cattoorseba/2ndlinefollower/code/proof of concepts/hbridge/Informatieve filmpjes Hbrug.docx

Informatieve filmpjes:

- Motor driver met 2 ingewerkte hbruggen: (L293)

https://www.youtube.com/watch?v=GAyzaVSBvN0

https://www.youtube.com/watch?v=D4yLsWvZDw4

https://www.youtube.com/shorts/5CbHtl4Vu8g

https://www.youtube.com/watch?v=GPVC84D5ULw
