cattoorseba/2ndlinefollower/code/finaal/library qtr.pdf

### LIBRARY

Om dit programma effecef te laten werken heb je een library nodig. Deze heet:

QTRSensors by Pololu
!!! VERSIE 3.1.0 !!!

hps://github.com/pololu/qtr-sensors-arduino
