cattoorseba/2ndlinefollower/images/456382504_514978801026128_8312329573464532869_n.jpg

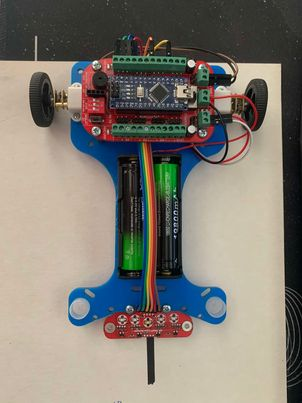
images/456382504_514978801026128_8312329573464532869_n.jpg
