cattoorseba/2ndlinefollower/images/457664521_521857643715942_9092791686252640069_n.jpg

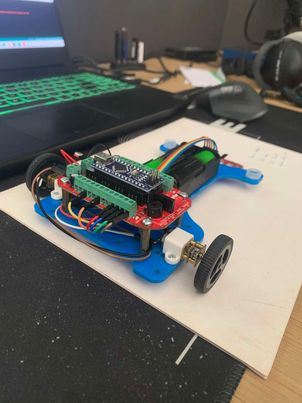
images/457664521_521857643715942_9092791686252640069_n.jpg
