cattoorseba/2ndlinefollower/bill of materials/readme.md

## bill of materials
<br />

|volgnummer|naam|omschrijving|nieuw/recup|kostprijs/stuk|aantal|subtotaal|
|---|----|---|---|---|---|---|
| 1| Basisplaat| Plastic uitgesneden basisplaat| nieuw| 20€| 1| 20€|
| 2| DC gear motor| 50:1 6V 650rpm| recup| 0€| 2| 0€|
| 3| Motorhouders| Plastic onderdeeltjes om de motor op zijn plek te houden| recup| 0€| 2| 0€|
| 4| Wieltjes| 30mm| recup| 0€| 2| 0€|
| 5| Arduino draadjes| (Male-Male)| recup| 0€| 4| 0€|
| 6| Arduino draadjes| (Male-Female)| recup| 0€| 6| 0€|
| 7| Arduino Robot Board| PCB Arduino-gebaseerde robotkaart| nieuw| 15€| 1| 15€|
| 8| L293 Motorsturing| motorsturing met 2 h-bruggen| recup| 0€| 1| 0€|
| 9| Arduino Nano| Atmega328| recup| 0€| 1| 0€|
| 10| Monteerstaafjes| bevestiging voor robot board op basisplaat| recup| 0€| 4| 0€|
| 11| Herlaadbare Li-ion batterij| 19800mAh, 3,7V| recup| 0€| 2| 0€|
| 12| Li-ion batterijhouder| batterijhouder 18650x2| recup| 0€| 1| 0€|
| 13| analoge Multi line sensor| wit (0-100) zwart (900-1023) bereik: 1-10mm werkspanning: 3,3-5V| nieuw| 7€| 1| 7€|
| 14| balanceerwieltjes (vooraan)| stabilisatiewieltjes zodat de linefollower niet sleept vooraan| recup| 0€| 2| 0€|
| 15| bouten| bevestigingsmateriaal (3 verschillende groottes)| recup| 0€| 12| 0€|
| 16| moeren| bevestigingsmateriaal (3verschillende groottes)| recup| 0€| 12| 0€|
| 17| rondellen| dik rondel voor batterijhouder| recup| 0€| 2| 0€|
