cattoorseba/2ndlinefollower/code/proof of concepts/interrupt/POC interrupt.pdf

# Interrupt Concept Schema

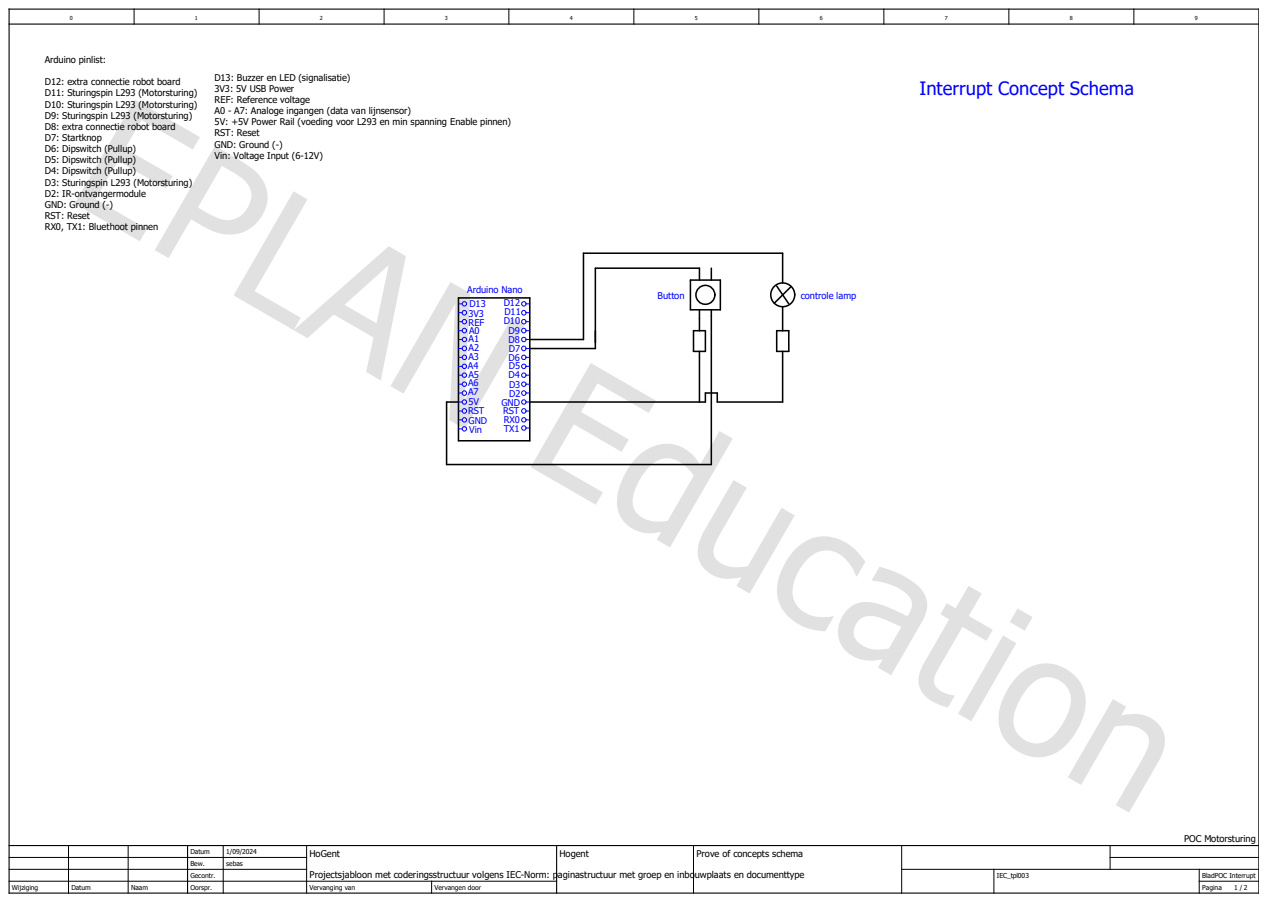
[picture p4: page 1]

D13: Buzzer en LED (signalisatie)
3V3: 5V USB Power
REF: Reference voltage
A0 - A7: Analoge ingangen (data van lijnsensor)
5V: +5V Power Rail (voeding voor L293 en min spanning Enable pinnen)
RST: Reset
GND: Ground (-)
Vin: Voltage Input (6-12V)

D12: extra connectie robot board
D11: Sturingspin L293 (Motorsturing)
D10: Sturingspin L293 (Motorsturing)
D9: Sturingspin L293 (Motorsturing)
D8: extra connectie robot board
D7: Startknop
D6: Dipswitch (Pullup)
D5: Dipswitch (Pullup)
D4: Dipswitch (Pullup)
D3: Sturingspin L293 (Motorsturing)
D2: IR-ontvangermodule
RX0, TX1: Bluethoot pinnen

Datum | 1/09/2024 | HoGent Projectsjabloon met coderingsstructuur volgens IEC-Norm: paginastructuur met groep en inbouwplaats en documenttype | Hogent | Prove of concepts schema
Bew. | sebas
Gecontr. | | | | | IEC_tpl003 | Blad POC Interrupt

Wijziging | Datum | Naam | Oorspr. | | Vervanging van | Vervangen door | | | | Pagina 1 / 2
