cattoorseba/2ndlinefollower/technische tekeningen/elektronisch/Finaal elektronisch schema linefollower.pdf

# Vin: Voltage Input (6-12V) L293 (MotorDriver)

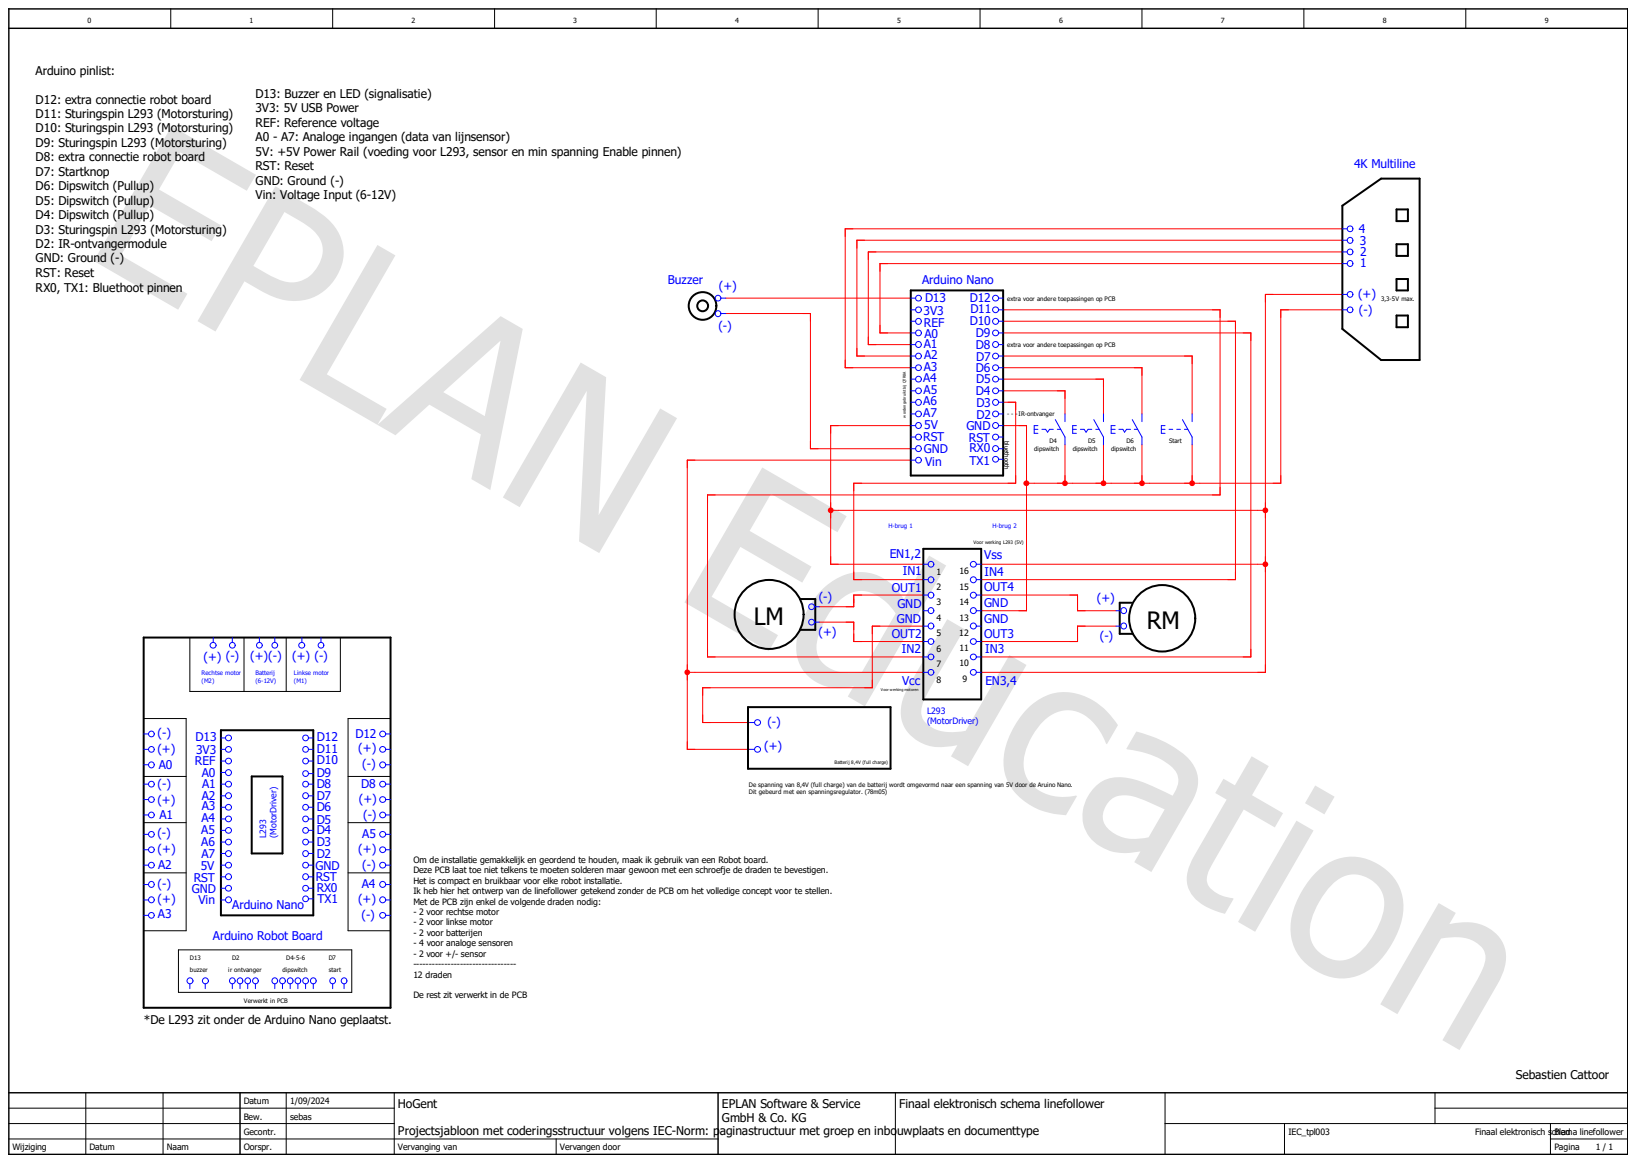
[picture p5: page 1]

D12: extra connectie robot board
D11: Sturingspin L293 (Motorsturing)
D10: Sturingspin L293 (Motorsturing)
D9: Sturingspin L293 (Motorsturing)
D8: extra connectie robot board
D7: Startknop
D6: Dipswitch (Pullup)
D5: Dipswitch (Pullup)
D4: Dipswitch (Pullup)
D3: Sturingspin L293 (Motorsturing)
D2: IR-ontvangermodule
GND: Ground (-)
RST: Reset
RX0, TX1: Bluethoot pinnen

D13: Buzzer en LED (signalisatie)
3V3: 5V USB Power
REF: Reference voltage
A0 - A7: Analoge ingangen (data van lijnsensor)
5V: +5V Power Rail (voeding voor L293, sensor en min spanning Enable pinnen)

extra voor andere toepassingen op PCB

H-brug 1 H-brug 2 Voor werking L293 (5V)

De spanning van 8,4V (full charge) van de batterij wordt omgevormd naar een spanning van 5V door de Aruino Nano.
Dit gebeurd met een spanningsregulator. (78m05)

Om de installatie gemakkelijk en geordend te houden, maak ik gebruik van een Robot board.
Deze PCB laat toe niet telkens te moeten solderen maar gewoon met een schroefje de draden te bevestigen.
Het is compact en bruikbaar voor elke robot installatie.
Ik heb hier het ontwerp van de linefollower getekend zonder de PCB om het volledige concept voor te stellen.
Met de PCB zijn enkel de volgende draden nodig:
- 2 voor rechtse motor
- 2 voor linkse motor
- 2 voor batterijen
- 4 voor analoge sensoren
- 2 voor +/- sensor
12 draden

De rest zit verwerkt in de PCB

*De L293 zit onder de Arduino Nano geplaatst.

Datum | 1/09/2024 | HoGent Projectsjabloon met coderingsstructuur volgens IEC-Norm: paginastructuur met groep en inbouwplaats en documenttype | EPLAN Software & Service GmbH & Co. KG | Finaal elektronisch schema linefollower
Bew. | sebas
Gecontr. | | | | | IEC_tpl003 Finaal elektronisch schema linefollower | Blad

Wijziging | Datum | Naam | Oorspr. | | Vervanging van | Vervangen door | | | | Pagina 1 / 1
