cattoorseba/2ndlinefollower/technische tekeningen/elektronisch/Elektrisch schema sensoren.pdf

Arduino Nano | Met QTR8A | Met 4K multiline sensor

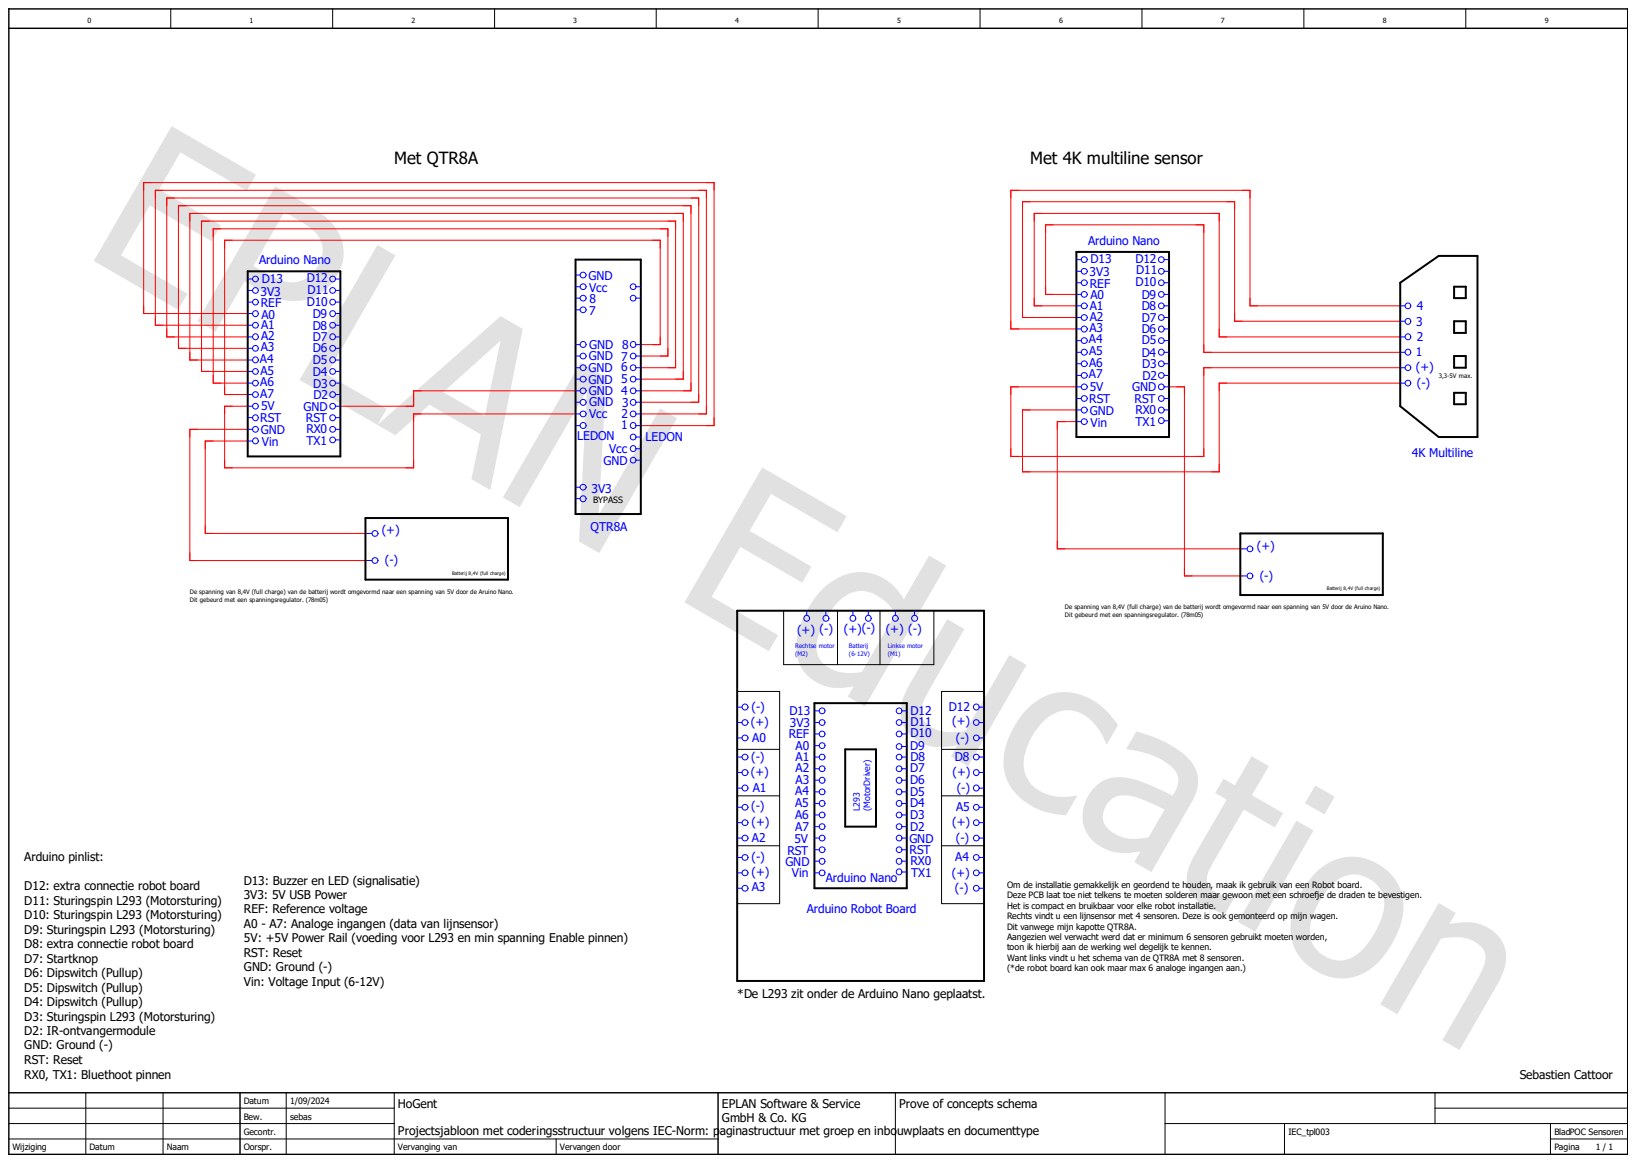
[picture p6: page 1]
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

D13: Buzzer en LED (signalisatie)
3V3: 5V USB Power
REF: Reference voltage
A0 - A7: Analoge ingangen (data van lijnsensor)
5V: +5V Power Rail (voeding voor L293 en min spanning Enable pinnen)
Vin: Voltage Input (6-12V)

Om de installatie gemakkelijk en geordend te houden, maak ik gebruik van een Robot board.
Deze PCB laat toe niet telkens te moeten solderen maar gewoon met een schroefje de draden te bevestigen.
Het is compact en bruikbaar voor elke robot installatie.
Rechts vindt u een lijnsensor met 4 sensoren. Deze is ook gemonteerd op mijn wagen.
Dit vanwege mijn kapotte QTR8A.
Aangezien wel verwacht werd dat er minimum 6 sensoren gebruikt moeten worden,
toon ik hierbij aan de werking wel degelijk te kennen.
Want links vindt u het schema van de QTR8A met 8 sensoren.
(*de robot board kan ook maar max 6 analoge ingangen aan.)

*De L293 zit onder de Arduino Nano geplaatst.

Datum | 1/09/2024 | HoGent Projectsjabloon met coderingsstructuur volgens IEC-Norm: paginastructuur met groep en inbouwplaats en documenttype | EPLAN Software & Service GmbH & Co. KG | Prove of concepts schema
Bew. | sebas
Gecontr. | | | | | IEC_tpl003 | Blad POC Sensoren

Wijziging | Datum | Naam | Oorspr. | | Vervanging van | Vervangen door | | | | Pagina 1 / 1
