cattoorseba/2ndlinefollower/technische tekeningen/elektronisch/elektrisch schema motorsturing.pdf

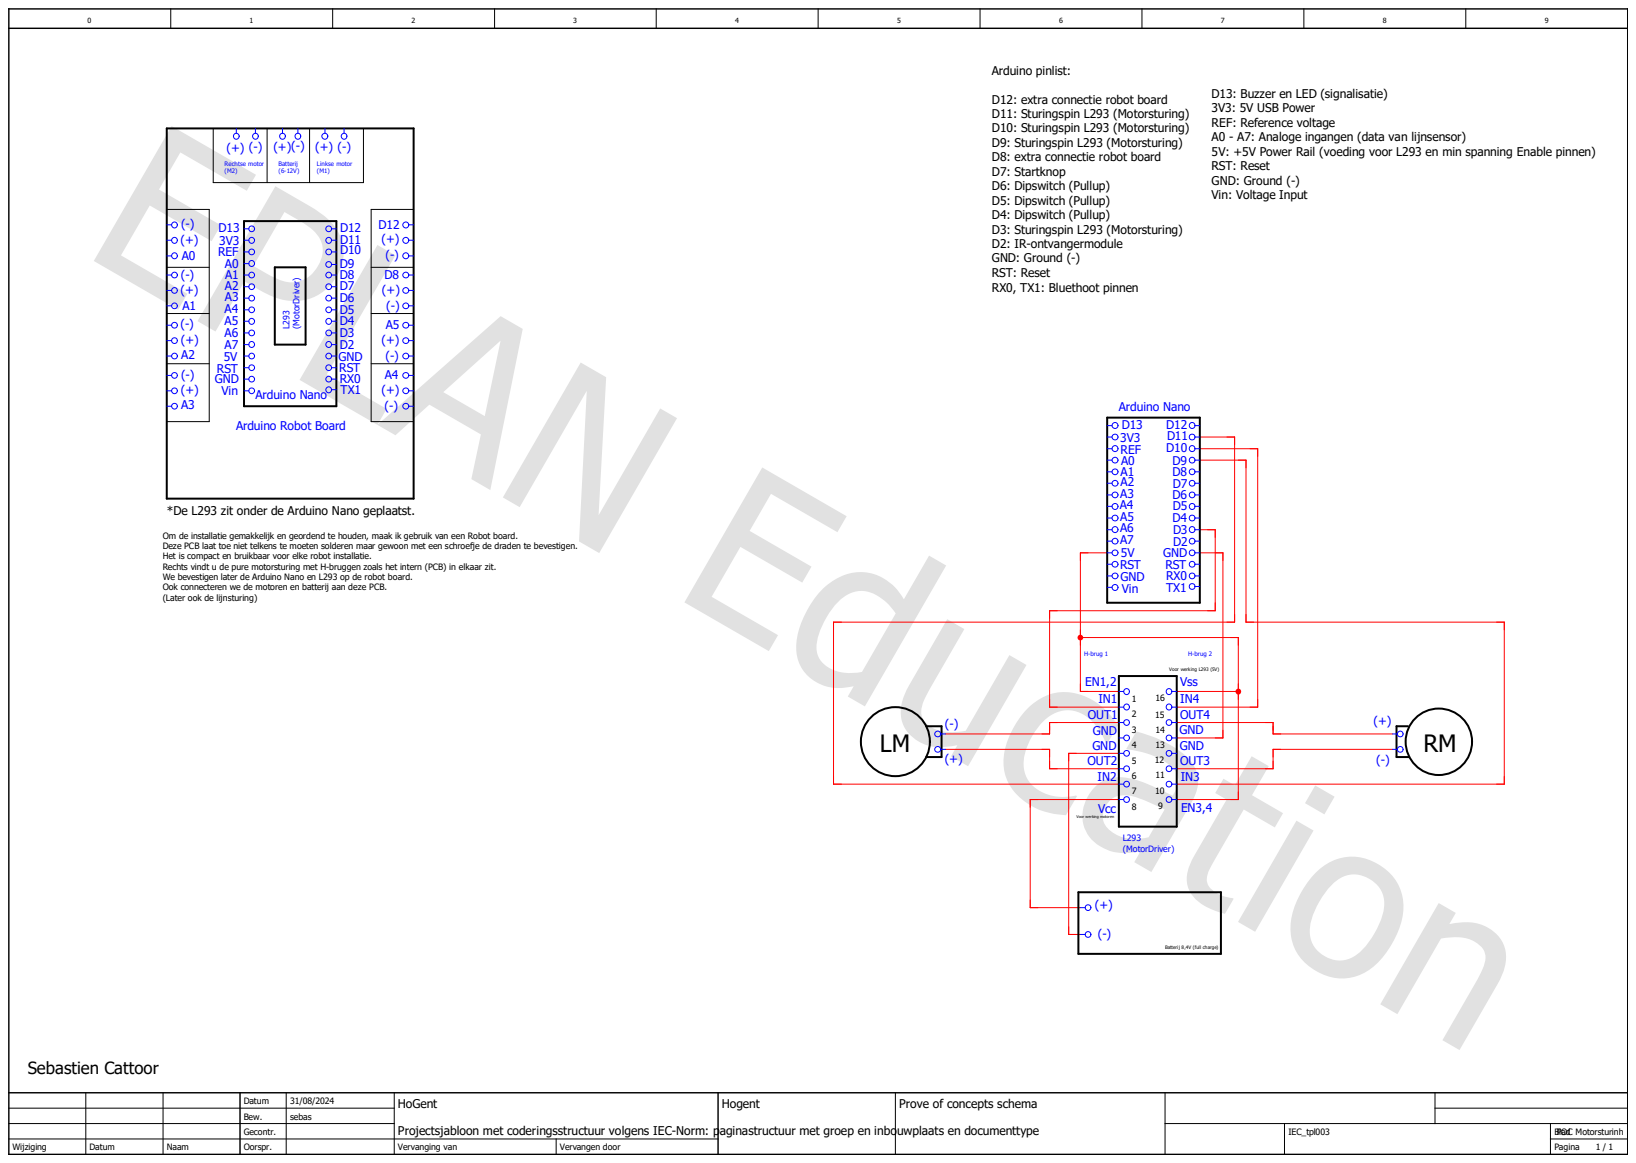
[picture p7: page 1]
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

*De L293 zit onder de Arduino Nano geplaatst.

Om de installatie gemakkelijk en geordend te houden, maak ik gebruik van een Robot board.
Deze PCB laat toe niet telkens te moeten solderen maar gewoon met een schroefje de draden te bevestigen.
Het is compact en bruikbaar voor elke robot installatie.
Rechts vindt u de pure motorsturing met H-bruggen zoals het intern (PCB) in elkaar zit.
We bevestigen later de Arduino Nano en L293 op de robot board.
Ook connecteren we de motoren en batterij aan deze PCB.
(Later ook de lijnsturing)

Datum | 31/08/2024 | HoGent Projectsjabloon met coderingsstructuur volgens IEC-Norm: paginastructuur met groep en inbouwplaats en documenttype | Hogent | Prove of concepts schema
Bew. | sebas
Gecontr. | | | | | IEC_tpl003 | Blad POC Motorsturinh

Wijziging | Datum | Naam | Oorspr. | | Vervanging van | Vervangen door | | | | Pagina
