cattoorseba/2ndlinefollower/(list of files, drawings)

Other design files:
technische tekeningen/elektronisch/easyeda_linefollower_planB.json
