cattoorseba/2ndlinefollower/(commit log)

2024-08-30 Update readme.md
    aanmaken/invullen materialenlijst.
2024-08-31 POC Motorsturing
2024-09-01 POC sensoren
